johnwinans/2055-LPC51U68JBD64-breakout/README.md

# 2055-LPC51U68JBD64-breakout
LPC51U68JBD64 Breakout Board

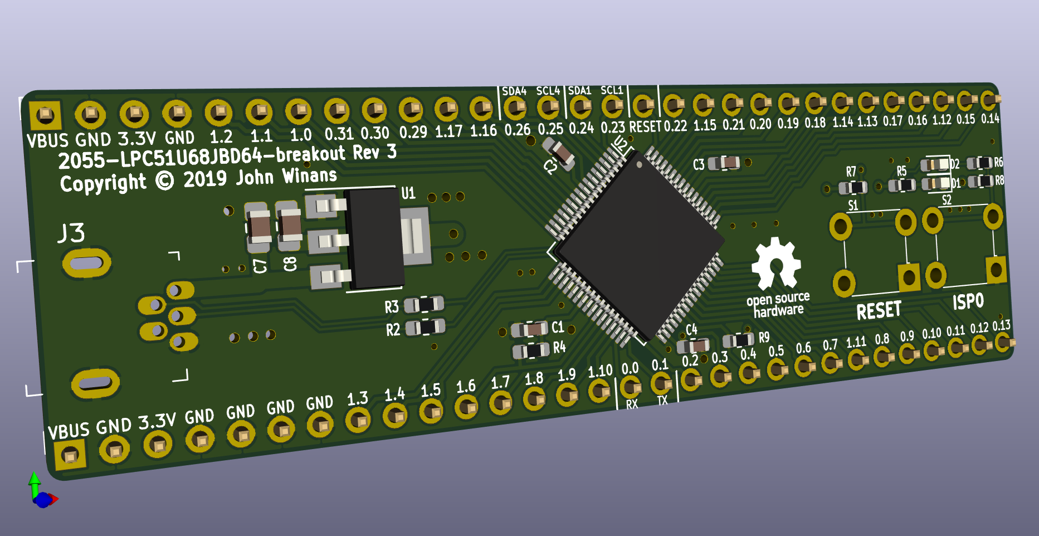
[picture p1: 2055-LPC51U68JBD64-breakout.png]
Front
