johnwinans/2055-LPC51U68JBD64-breakout/2055-LPC51U68JBD64-breakout.pdf

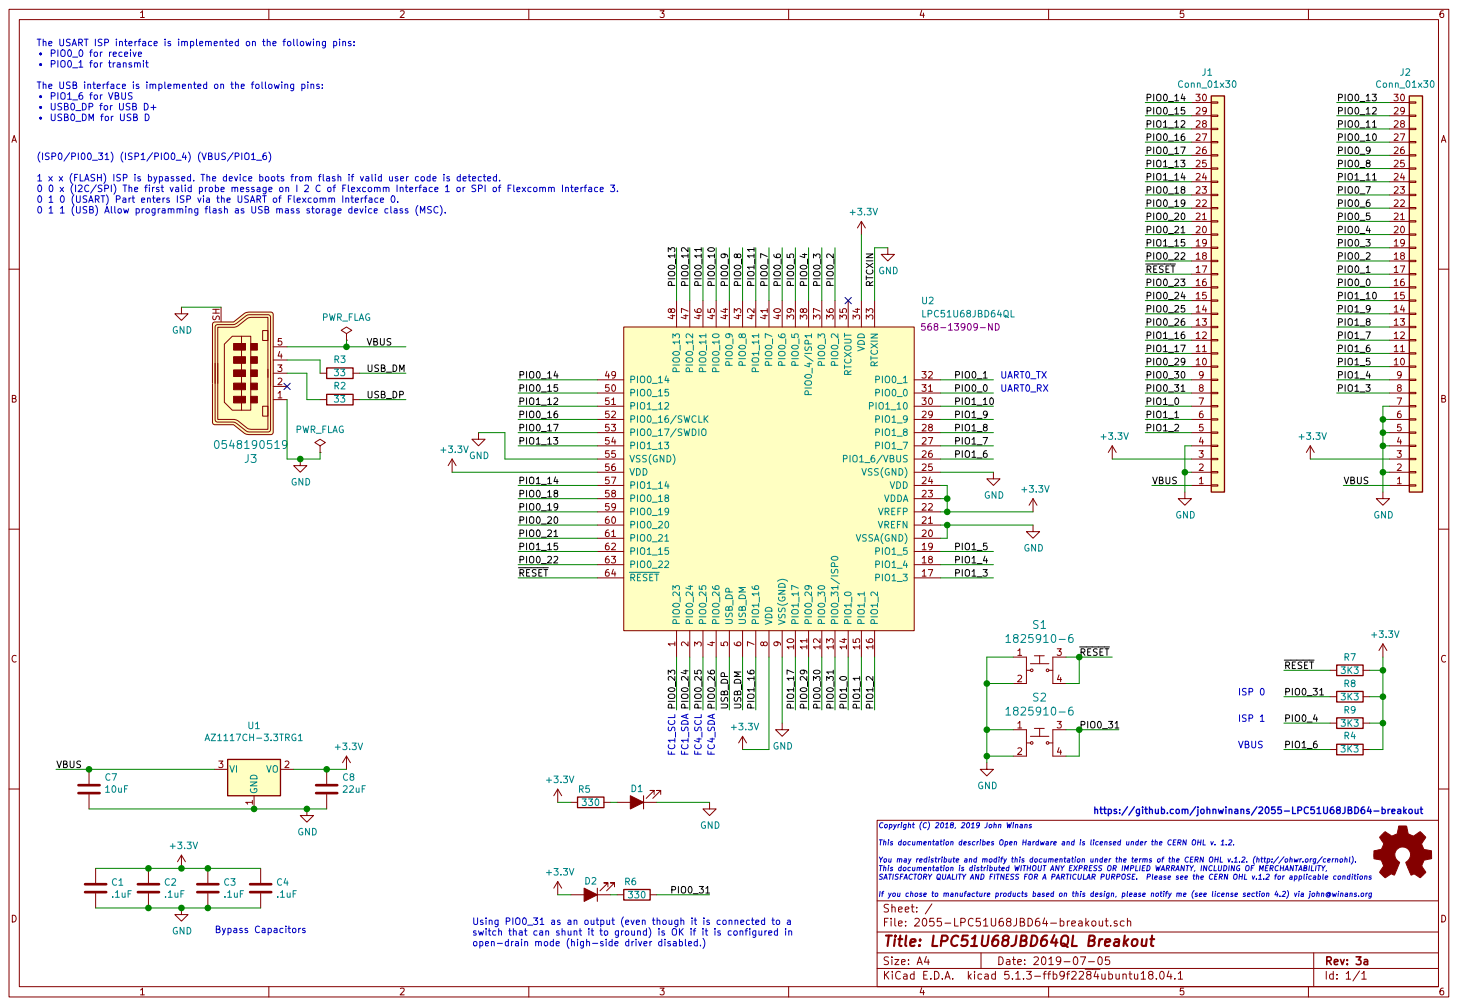
[picture p2: page 1]

The USART ISP interface is implemented on the following pins:
PIO0_0 for receive
PIO0_1 for transmit The USB interface is implemented on the following pins:

1 x x (FLASH) ISP is bypassed. The device boots from flash if valid user code is detected.
0 0 x (I2C/SPI) The first valid probe message on I 2 C of Flexcomm Interface 1 or SPI of Flexcomm Interface 3.
0 1 0 (USART) Part enters ISP via the USART of Flexcomm Interface 0.
0 1 1 (USB) Allow programming flash as USB mass storage device class (MSC).

5 PIO0_15 50 PIO1_12 51 PIO0_16/SWCLK 52 PIO0_17/SWDIO 53 PIO1_13 54 VSS(GND) 55 VDD 56 PIO1_14 57 PIO0_18 58 PIO0_19 59 USB_DM

2 VSSA(GND) 20 VREFN 21 VREFP 22 VDDA 23 VDD 24 VSS(GND) 25 PIO1_6/VBUS 26 PIO1_7 27 PIO1_8 28 PIO1_9 29 PIO0_25

https://github.com/johnwinans/2055-LPC51U68JBD64-breakout VBUS

If you chose to manufacture products based on this design, please notify me (see license section 4.2) via john@winans.org

Using PIO0_31 as an output (even though it is connected to a
switch that can shunt it to ground) is OK if it is configured in
