johnwinans/2055-LPC51U68JBD64-breakout/2055-LPC51U68JBD64-breakout.kicad_pcb

## KiCad design 2055-LPC51U68JBD64-breakout.kicad_pcb (2019-07-28)

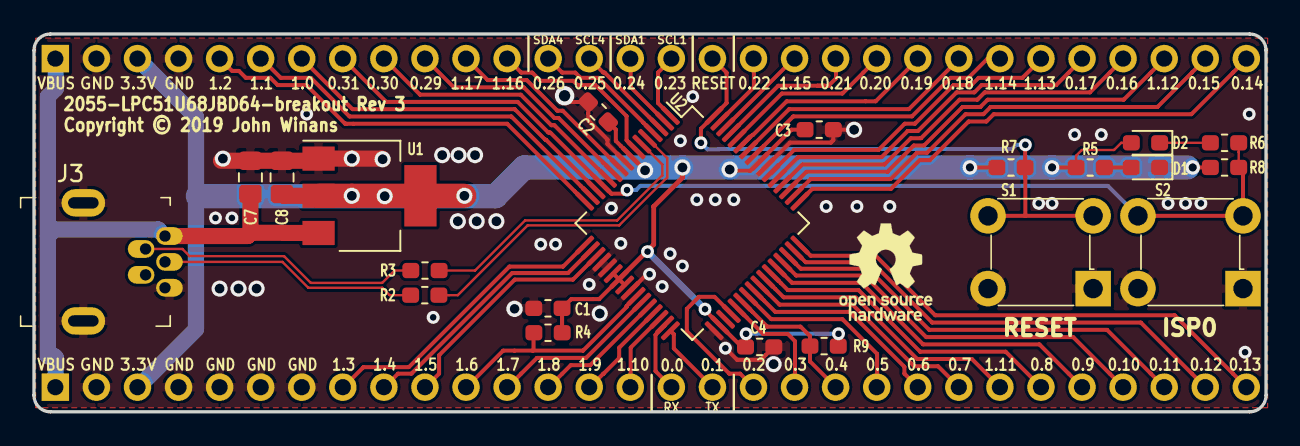
[picture p3: board 2055-LPC51U68JBD64-breakout.kicad_pcb from above]

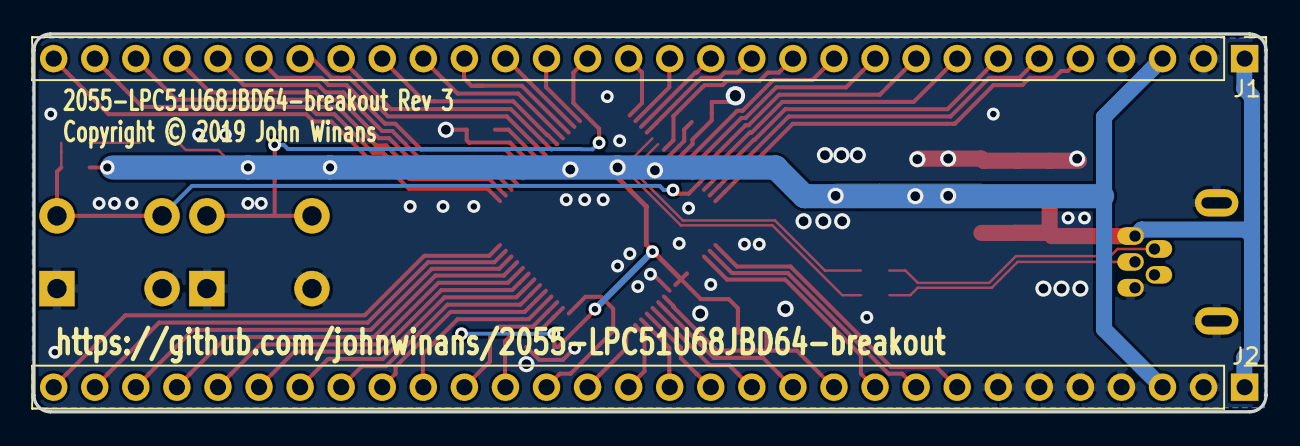
[picture p4: board 2055-LPC51U68JBD64-breakout.kicad_pcb from below]

Board: 2 copper layers, 76.2 x 23.4 mm, 24 parts (2 on the bottom side), 58 nets.

Parts:
C1, C2, C3, C4: .1uF; C_0603_1608Metric_Pad1.05x0.95mm_HandSolder
C7: 10uF; C_0805_2012Metric_Pad1.15x1.40mm_HandSolder
C8: 22uF; C_0805_2012Metric_Pad1.15x1.40mm_HandSolder
D1, D2: LED_ALT; LED_0603_1608Metric_Pad1.05x0.95mm_HandSolder
J1, J2: Conn_01x30; PinHeader_1x30_P2.54mm_Vertical
J3: 0548190519; USB_Mini_B_Female_548190519
LOGO1: Logo_Open_Hardware_Small; OSHW-Logo_5.7x6mm_SilkScreen
R2, R3: 33; R_0603_1608Metric_Pad1.05x0.95mm_HandSolder
R4, R7, R8, R9: 3K3; R_0603_1608Metric_Pad1.05x0.95mm_HandSolder
R5, R6: 330; R_0603_1608Metric_Pad1.05x0.95mm_HandSolder
S1, S2: 1825910-6; Switch_Tactile_THT_6x6mm
U1: AZ1117CH-3.3TRG1; SOT-223-3_TabPin2
U2: LPC51U68JBD64QL; TQFP-64_10x10mm_P0.5mm

Connections:
+3V3: C1.1, C2.1, C3.1, C4.1, C8.1, D2.2, J1.3, J2.3, R4.2, R5.2, R7.1, R8.1, R9.1, U1.2, U2.8, U2.22, U2.23, U2.24, U2.34, U2.56
/PIO0_0: J2.16, U2.31
/PIO0_1: J2.17, U2.32
/PIO0_2: J2.18, U2.36
/PIO0_3: J2.19, U2.37
/PIO0_4: J2.20, R9.2, U2.38
/PIO0_5: J2.21, U2.39
/PIO0_6: J2.22, U2.40
/PIO0_7: J2.23, U2.41
/PIO0_8: J2.25, U2.43
/PIO0_9: J2.26, U2.44
/PIO0_10: J2.27, U2.45
/PIO0_11: J2.28, U2.46
/PIO0_12: J2.29, U2.47
/PIO0_13: J2.30, U2.48
/PIO0_14: J1.30, U2.49
/PIO0_15: J1.29, U2.50
/PIO0_16: J1.27, U2.52
/PIO0_17: J1.26, U2.53
/PIO0_18: J1.23, U2.58
/PIO0_19: J1.22, U2.59
/PIO0_20: J1.21, U2.60
/PIO0_21: J1.20, U2.61
/PIO0_22: J1.18, U2.63
/PIO0_23: J1.16, U2.1
/PIO0_24: J1.15, U2.2
/PIO0_25: J1.14, U2.3
/PIO0_26: J1.13, U2.4
/PIO0_29: J1.10, U2.11
/PIO0_30: J1.9, U2.12
/PIO0_31: J1.8, R6.1, R8.2, S2.3, S2.4, U2.13
/PIO1_0: J1.7, U2.14
/PIO1_1: J1.6, U2.15
/PIO1_2: J1.5, U2.16
/PIO1_3: J2.8, U2.17
/PIO1_4: J2.9, U2.18
/PIO1_5: J2.10, U2.19
/PIO1_6: J2.11, R4.1, U2.26
/PIO1_7: J2.12, U2.27
/PIO1_8: J2.13, U2.28
/PIO1_9: J2.14, U2.29
/PIO1_10: J2.15, U2.30
/PIO1_11: J2.24, U2.42
/PIO1_12: J1.28, U2.51
/PIO1_13: J1.25, U2.54
/PIO1_14: J1.24, U2.57
/PIO1_15: J1.19, U2.62
/PIO1_16: J1.12, U2.7
/PIO1_17: J1.11, U2.10
/USB_DM: R3.2, U2.6
/USB_DP: R2.2, U2.5
/VBUS: C7.1, J1.1, J2.1, J3.5, U1.3
/~RESET~: J1.17, R7.2, S1.3, S1.4, U2.64
GND: C1.2, C2.2, C3.2, C4.2, C7.2, C8.2, D1.1, J1.2, J1.4, J2.2, J2.4, J2.5, J2.6, J2.7, J3.1, J3.SH, S1.1, S1.2, S2.1, S2.2, U1.1, U2.9, U2.20, U2.21, U2.25, U2.33, U2.55
unnamed: D1.2, R5.1
unnamed: D2.1, R6.2
unnamed: J3.3, R2.1
unnamed: J3.4, R3.1
