johnwinans/2055-LPC51U68JBD64-breakout/(commit log)

2019-07-05 Initial import of Rev 2 forked from 2042.
    [2055-LPC51U68JBD64-breakout.kicad_pcb, 2055-LPC51U68JBD64-breakout.sch]
2019-07-05 Update the copyright date
    [2055-LPC51U68JBD64-breakout.sch]
2019-07-08 Adjust edge cuts arc with wrong thickness.
    [2055-LPC51U68JBD64-breakout.kicad_pcb]
2019-07-08 Fix rev number on front silkscreen
    [2055-LPC51U68JBD64-breakout.kicad_pcb]
2019-07-08 Fix rev number on back silkscreen
    [2055-LPC51U68JBD64-breakout.kicad_pcb]
2019-07-08 Added schematic pdf & open-source license files
    [2055-LPC51U68JBD64-breakout.sch]
2019-07-13 Reverse J3 pin order.
    [2055-LPC51U68JBD64-breakout.kicad_pcb, 2055-LPC51U68JBD64-breakout.sch]
2019-07-27 Added gerbers for ordering from PCBWay.
    [2055-LPC51U68JBD64-breakout-B_Cu.gbl, 2055-LPC51U68JBD64-breakout-B_Mask.gbs, 2055-LPC51U68JBD64-breakout-B_Paste.gbp, 2055-LPC51U68JBD64-breakout-B_SilkS.gbo, 2055-LPC51U68JBD64-breakout-Edge_Cuts.gm1, 2055-LPC51U68JBD64-breakout-F_Cu.gtl, 2055-LPC51U68JBD64-breakout-F_Mask.gts, 2055-LPC51U68JBD64-breakout-F_Paste.gtp]
2019-07-27 Correct thermal releif around C7 & C8.
    [2055-LPC51U68JBD64-breakout-B_Cu.gbl, 2055-LPC51U68JBD64-breakout-B_Mask.gbs, 2055-LPC51U68JBD64-breakout-B_Paste.gbp, 2055-LPC51U68JBD64-breakout-B_SilkS.gbo, 2055-LPC51U68JBD64-breakout-Edge_Cuts.gm1, 2055-LPC51U68JBD64-breakout-F_Cu.gtl, 2055-LPC51U68JBD64-breakout-F_Mask.gts, 2055-LPC51U68JBD64-breakout-F_Paste.gtp]
2019-07-28 Clean up Digikey order numbers in the BOM.
    [2055-LPC51U68JBD64-breakout.csv, 2055-LPC51U68JBD64-breakout.kicad_pcb, 2055-LPC51U68JBD64-breakout.sch]
2019-07-28 Update Rev number to 3a in the schematic title block.
