johnwinans/2055-LPC51U68JBD64-breakout/(notices)

Notices in the files:
2055-LPC51U68JBD64-breakout.kicad_pcb:
Copyright © 2019 John Winans
2055-LPC51U68JBD64-breakout.sch:
Copyright (C) 2018, 2019 John Winans
This documentation describes Open Hardware and is licensed under the CERN OHL v. 1.2.
You may redistribute and modify this documentation under the terms of the CERN OHL v.1.2. (http://ohwr.org/cernohl).
